CFLadestationen/CfOnlinestatus/doc/CFOSconfig1.png

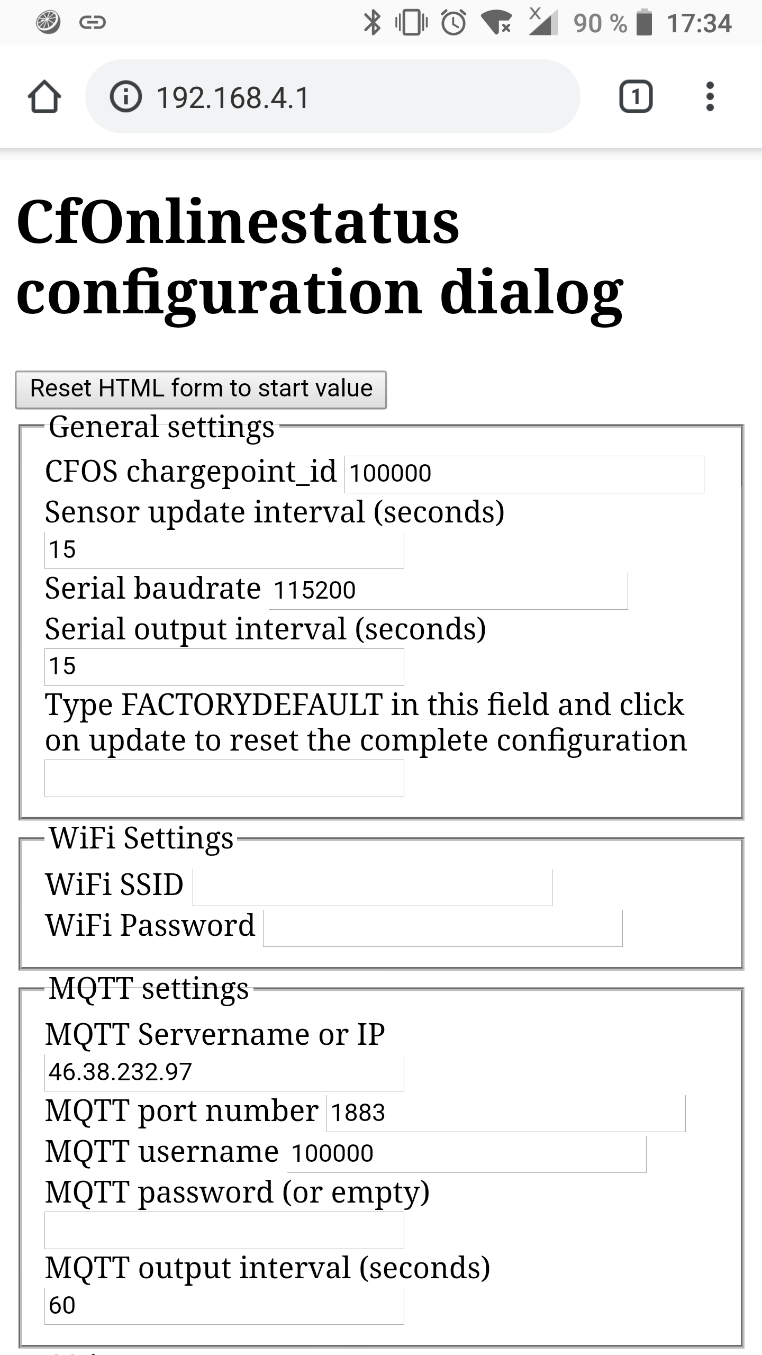
doc/CFOSconfig1.png
