CFLadestationen/CfOnlinestatus/doc/CFOSconfig2.png

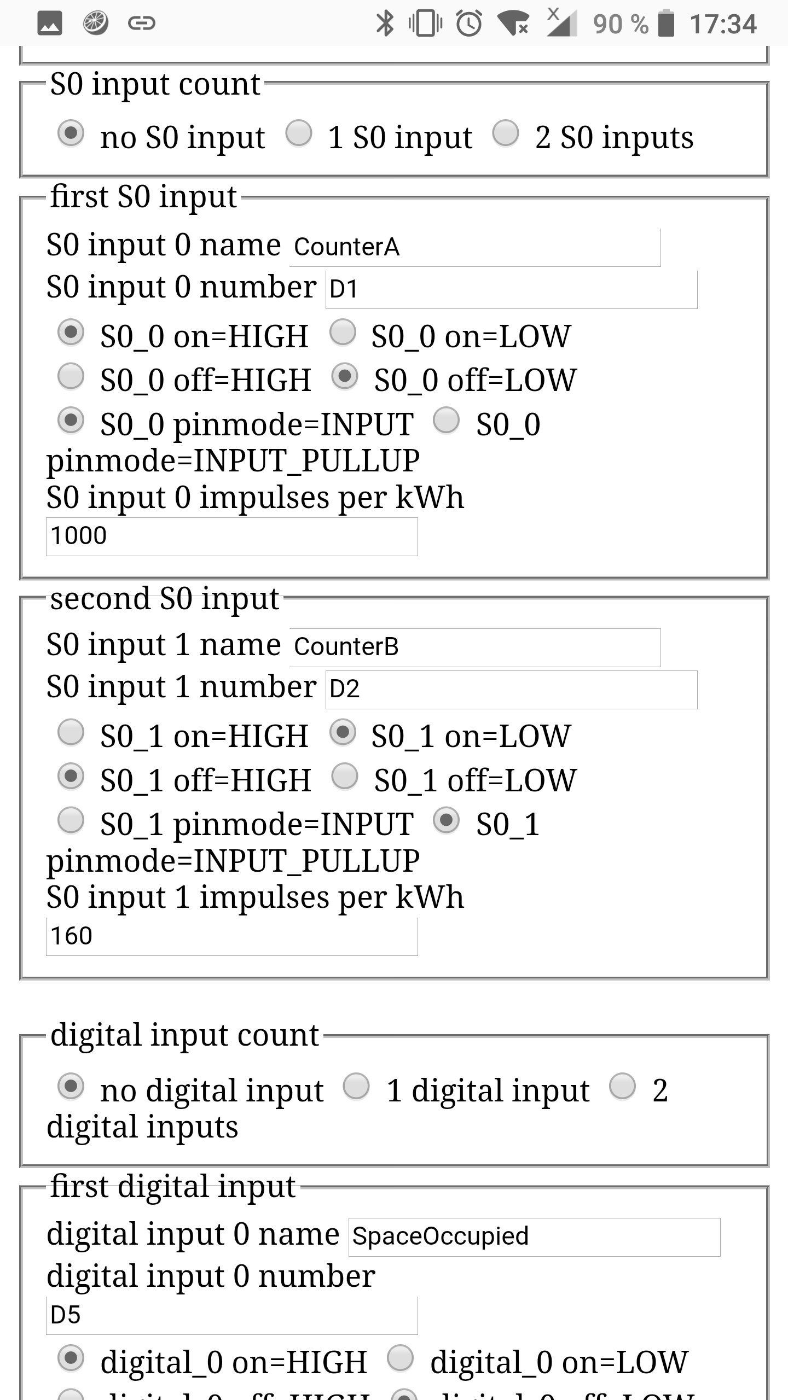
doc/CFOSconfig2.png
