CFLadestationen/CfOnlinestatus/doc/CFOSconfig3.png

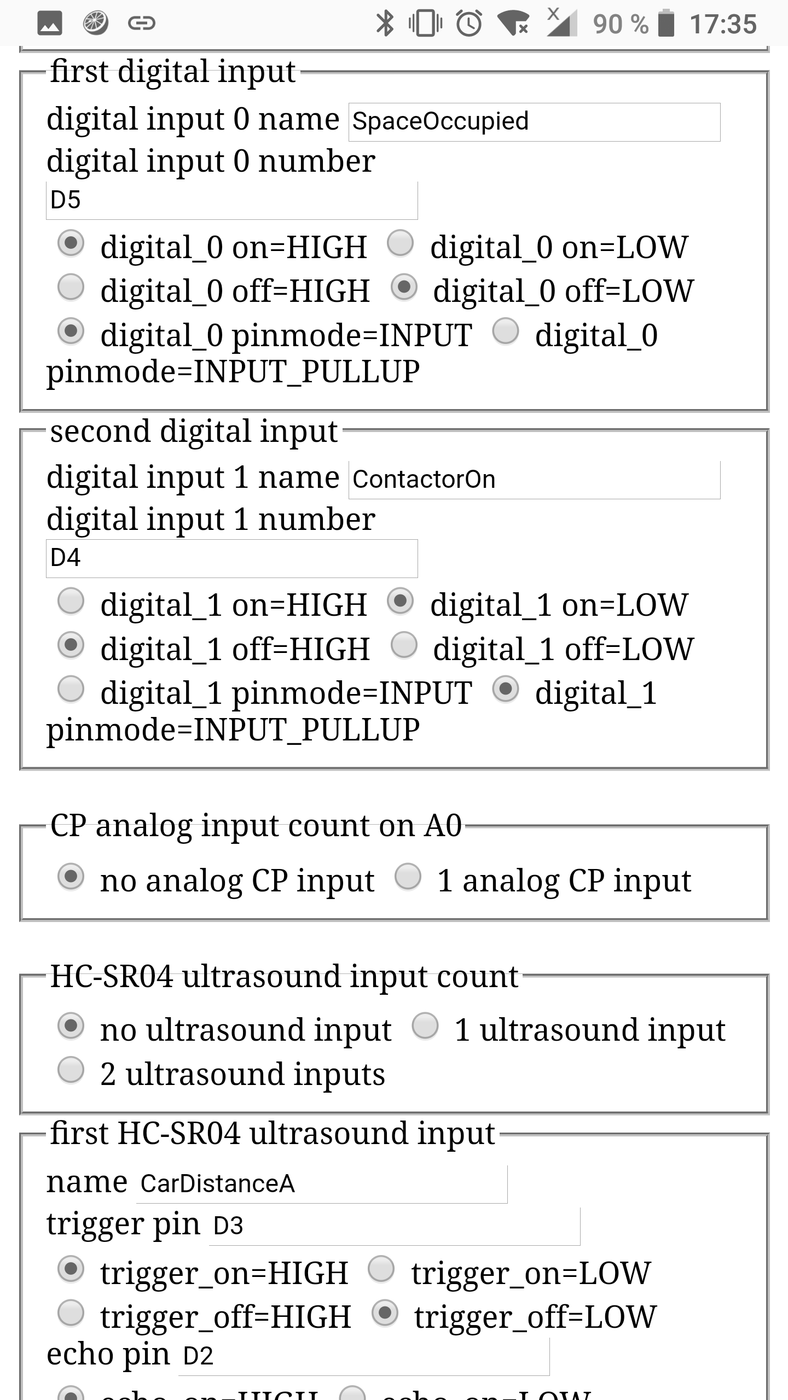
doc/CFOSconfig3.png
