CFLadestationen/CfOnlinestatus/doc/CFOSconfig4.png

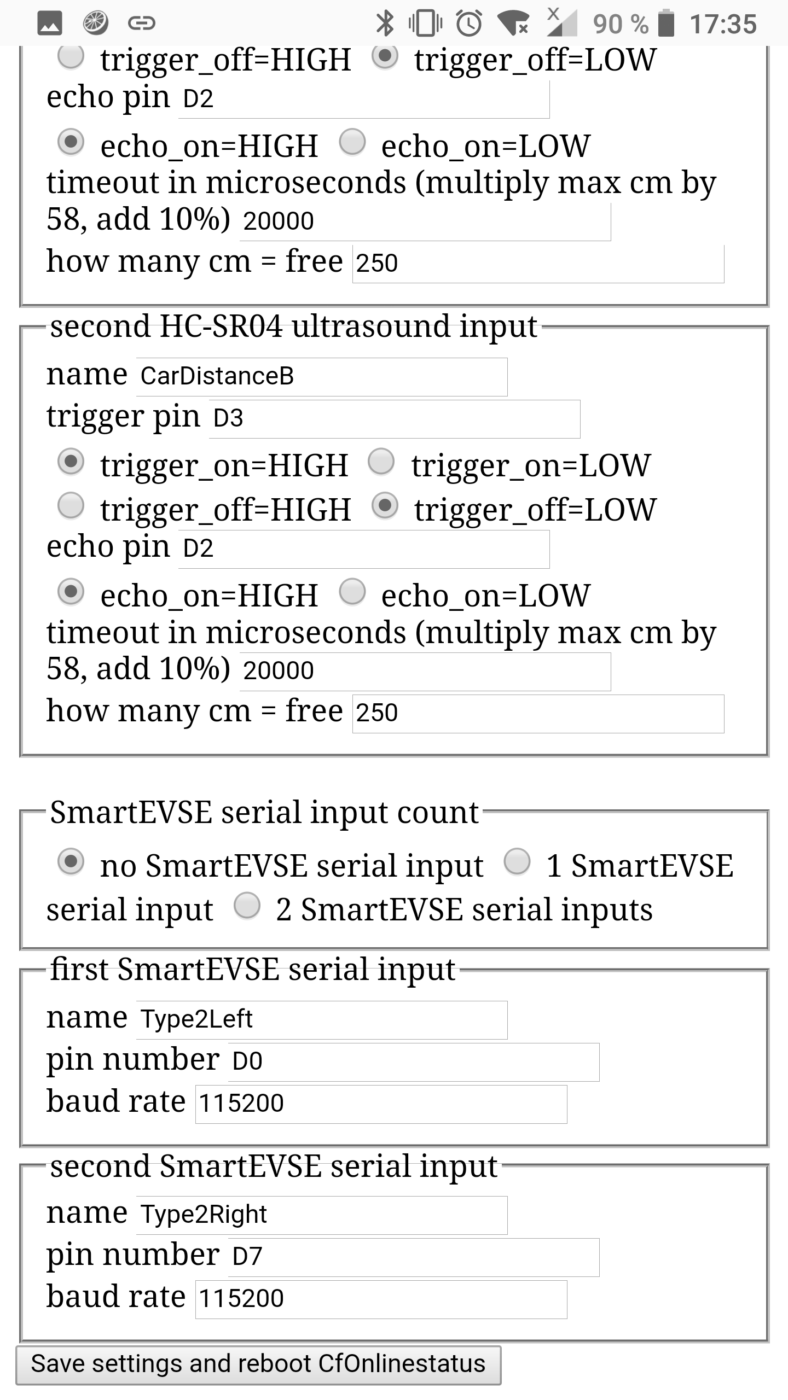
doc/CFOSconfig4.png
