CFLadestationen/CfOnlinestatus/doc/CFOSconfig5.png

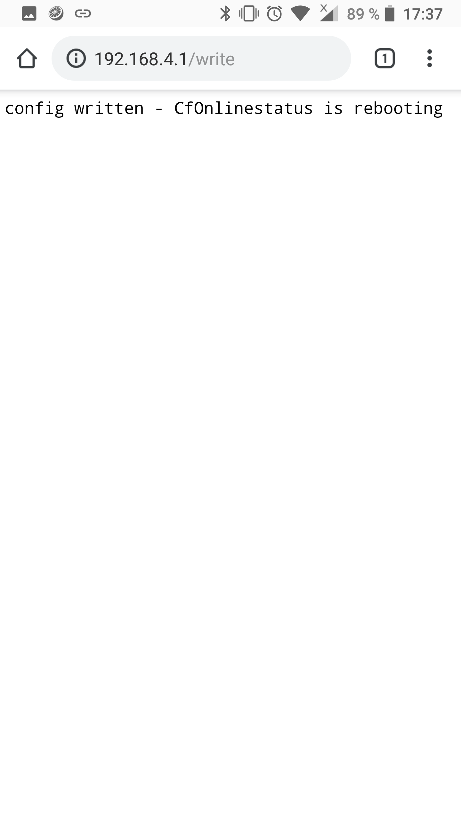
doc/CFOSconfig5.png
