CFLadestationen/CfOnlinestatus/backend/influxdb/setup.txt

influx
CREATE DATABASE CfOnlinestatus
CREATE USER telegraf WITH PASSWORD 'xxx'
