CFLadestationen/CfOnlinestatus/ComBOX V1.4 brd.pdf

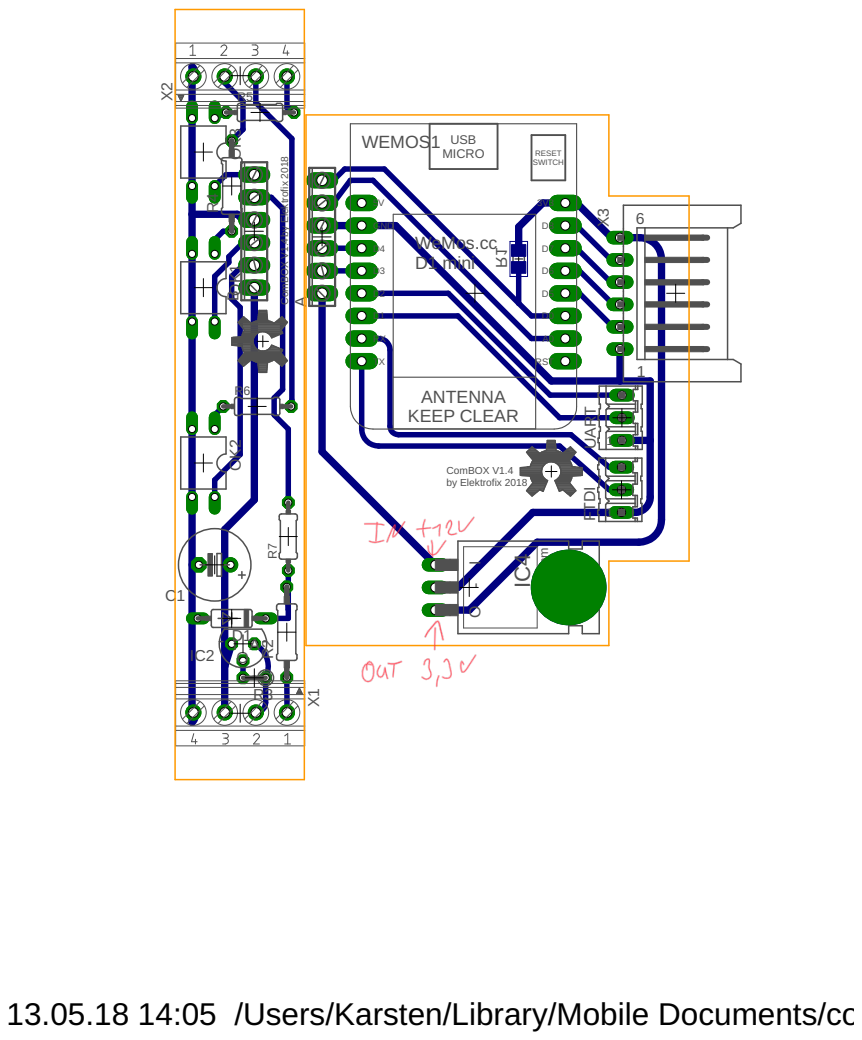
[picture p6: page 1]

13.05.18 14:05 /Users/Karsten/Library/Mobile Documents/com~apple~CloudDocs/ComBox/ComBOX V1.4.brd
