CFLadestationen/CfOnlinestatus/ComBOX V1.4 sch.pdf

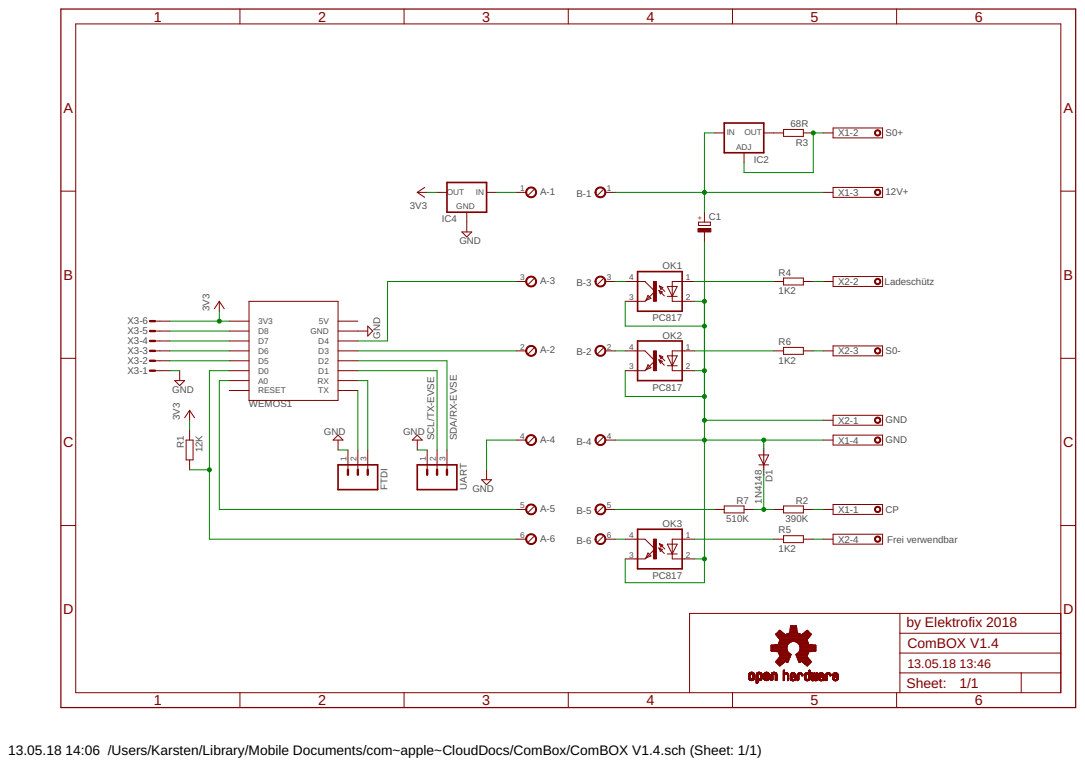
[picture p7: page 1]

13.05.18 14:06 /Users/Karsten/Library/Mobile Documents/com~apple~CloudDocs/ComBox/ComBOX V1.4.sch (Sheet: 1/1)
