CFLadestationen/CfOnlinestatus/(commit log)

2018-02-06 S0 impulse counting and output
    Added a first sketch to read S0 inputs and print them on the serial console. WARNING: Completely untested - I did not have an Arduino at hand!
2018-02-08 Changed pin definition to a struct, Added name to S0 inputs
    Changed pin definition to a struct
    Added name to S0 inputs
2018-02-08 Added analog pin handling
    Added analog pin handling
2018-02-10 Added #define for selection of features
    Many #define were added for the selection of hardware and software features. Sample output:
    CfOnlinestatus id CFMusterstadtGoethestr12 starting with following features:
    Hardware platform: WeMos D1 R2 & mini
    2 S0 pin(s)
    2 digital input pin(s)
    1 analog input pin(s)
    1 HC-SR04 ultrasound sensor(s)
    GSM connection (not implemented yet!)
    Configured pin number 5 as S0 pin named CounterA
    Configured pin number 4 as S0 pin named CounterB
    Configured pin number 14 as digital input pin named SpaceOccupied
    Configured pin number 2 as digital input pin named ContactorOn
    Configured pin number 17 as analog input pin named PPVoltage with low threshold 87 and high thresho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
2018-02-19 Renamed directory arduino_sketch to sketch
    Renamed directory arduino_sketch to sketch
2018-02-19 Renamed arduino_sketch.ino to sketch.ino
2018-03-10 Update README
    Added central MQQT Broker for GoingElectric Cf charging stations.
2018-03-10 Updated sketch.io
    Analog high low mid renamed to standby, ready charging, vehicle detected regarding to IEC 62196 Typ 2
2018-03-10 Updated README.md
    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
2018-03-13 Added S0 power calculation and output
2018-03-29 Changed output values for analog input and SmartEVSE so that they match. Fixed docs.
    [sketch.ino]
2018-03-30 Fixed typo, started work on lora overhaul
    [cfos_types.h, sketch.ino]
2018-03-30 Making it compile for Arduino
    Currently, the software cannot be compiled for arduino because of too much RAM usage.
    [sketch.ino]
2018-03-30 Added antenna information
2018-11-18 Remove Arduino, add screenshots to documentation
    Remove Arduino, add screenshots to documentation
